kicajsky/zasilacz-warsztatowy-Altium/zasilacz zmontowany.jpg

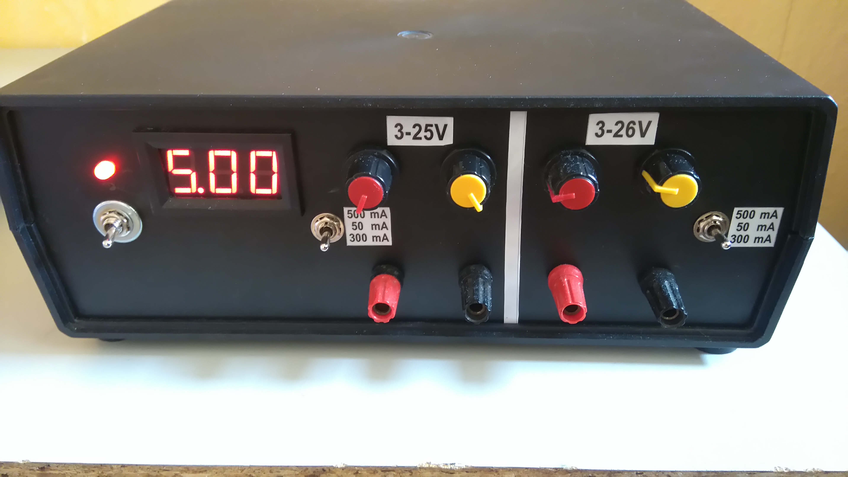
zasilacz zmontowany.jpg
