kicajsky/zasilacz-warsztatowy-Altium/Project Outputs for PCB_Project1/2017-02-09 11.30.52.jpg

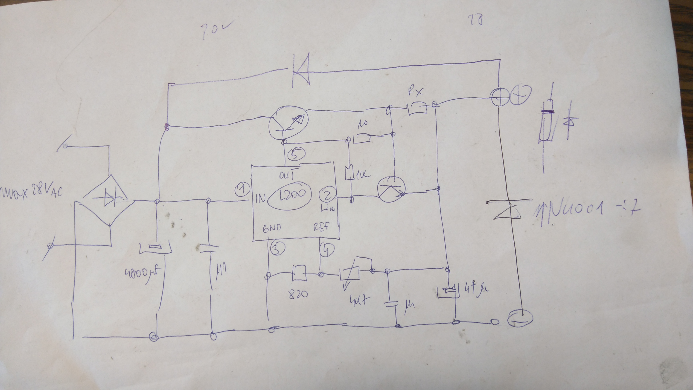
Project Outputs for PCB_Project1/2017-02-09 11.30.52.jpg
