kicajsky/zasilacz-warsztatowy-Altium/README.md

# zasilacz-warsztatowy-Altium
projekt zasilacza warsztatowego. 2x 3-25V 50-500mA do zasilania wzmacniaczy operacyjnych
