kicajsky/zasilacz-warsztatowy-Altium/Project Outputs for PCB_Project1/BOM.xls

Item # | Quantity | Designator | Description | Comment | LibRef
1 | 2 | C1, C2 | Capacitor (Semiconductor SIM Model) | Cap Semi | Cap Semi
2 | 1 | C3 | Polarized Capacitor (Radial) | Cap Pol1 | Cap Pol1
3 | 1 | C4 | Polarized Capacitor (Radial) | Cap Pol1 | Cap Pol1
4 | 1 | D1 | Typical INFRARED GaAs LED | LED0 | LED0
5 | 1 | D2 | Default Diode | Diode 159 | Diode
6 | 1 | D3 | 1 Amp General Purpose Rectifier | Diode 1N4001 | Diode 1N4001
7 | 1 | F1 | Fuse | Fuse 1 | Fuse 1
8 | 1 | J1 | IEC Mains Power Outlet, EN60 320-2-2 F Class I, PC Flange Rear Mount, Chassis Socket | Plug AC Female | Plug AC Female
9 | 1 | M1 | Full Wave Diode Bridge | Bridge1 | Bridge1
10 | 2 | OUT1, OUT2 | Wyjście zasilacza typu Banan | Banan | Banan
11 | 7 | R1, R2, R3, R4, R5, R6, R9 | Resistor | Res2 | Res2
12 | 2 | R7, R8 | Potentiometer | RPot | RPot
13 | 1 | S1 | Double-Pole, Single-Throw Switch | SW-DPST | SW-DPST
14 | 1 | SW1 | Single 3-stage toggle switch | toggle_switch_3_mono | toggle_switch_3_mono
15 | 1 | SW2 | Dual 3-stage toggle switch | toggle_switch_3 | toggle_switch_3
16 | 1 | T1 | Amplifier Transistor, NPN Silicon, 3-Pin TO-92, Bulk Box | BC547B | BC547B
17 | 1 | T2 | NPN Silicon Power Transistor, 3-Pin TO-220, Tube | BUV27 | BUV27
18 | 1 | Tr1 | Transformer (Coupled Inductor Model) | Trans Cupl | Trans Cupl
19 | 1 | US1 | Adjustable Voltage and Current Regulator, 5-Pin Pentawatt, Tube | L200C | L200CV
20 | 1 | V1 | Woltomierz DC 1-30V | Woltomierz | woltomierz
21 | 2 | Z1, Z2 | Połączenie z płytką pcb. Przewodem z uzwojenia wtórnego do mostka Gretza | Connect | NET
