kicajsky/zasilacz-warsztatowy-Altium/Project Outputs for PCB_Project1/pcb1.pdf

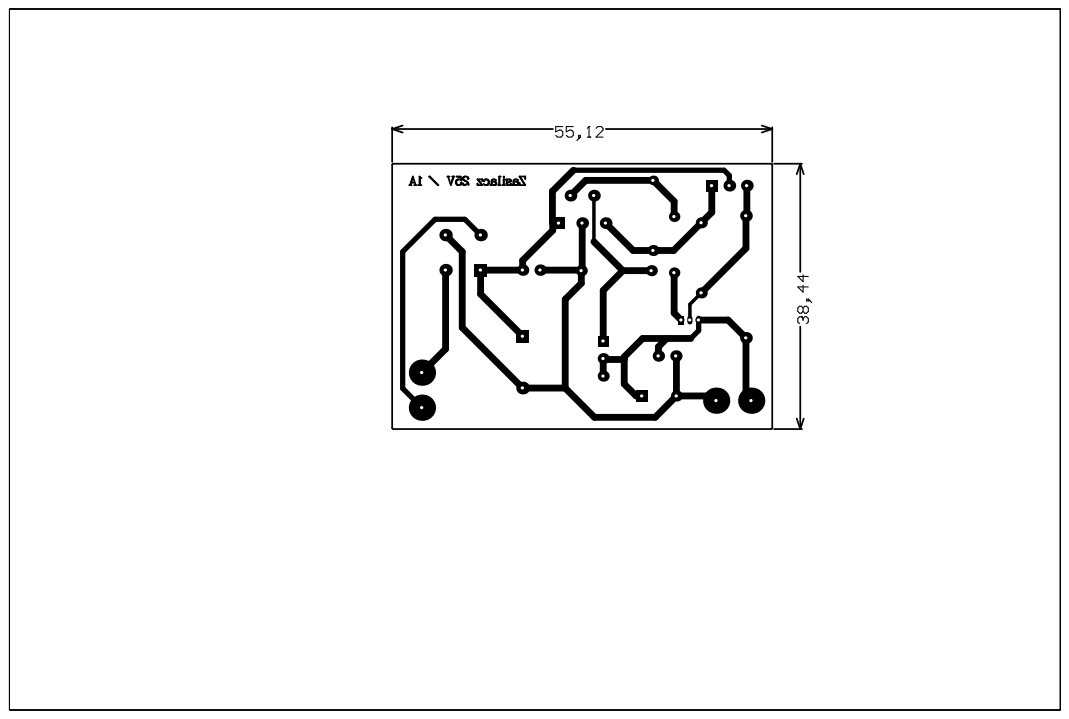
[picture p5: page 1]

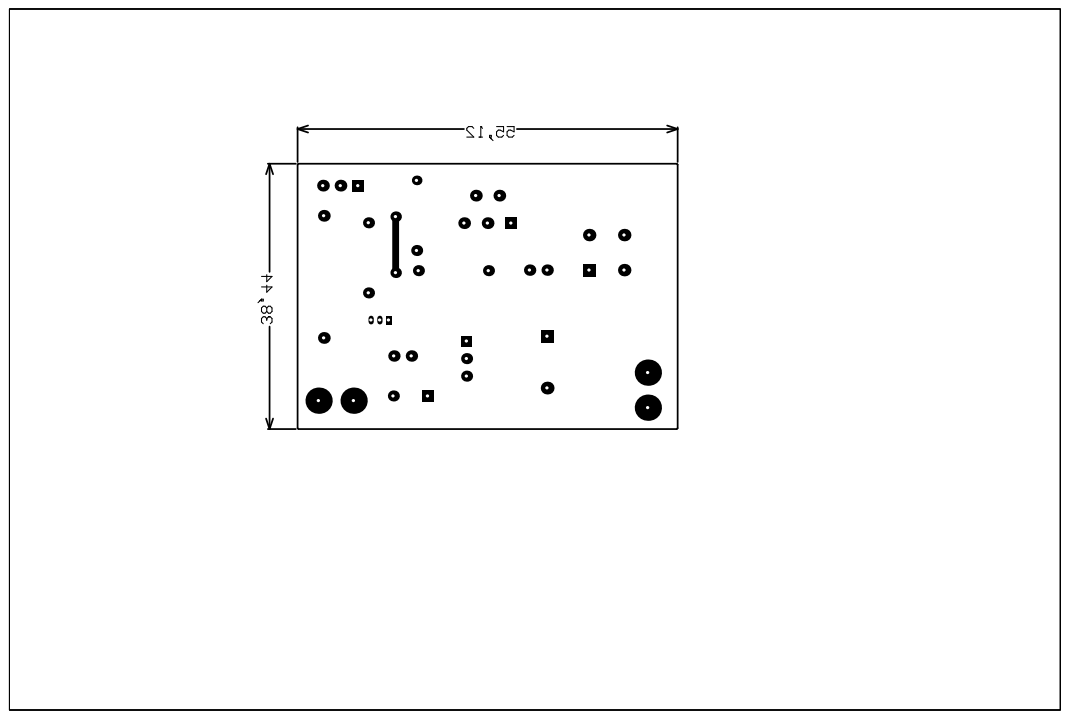
[picture p6: page 2]

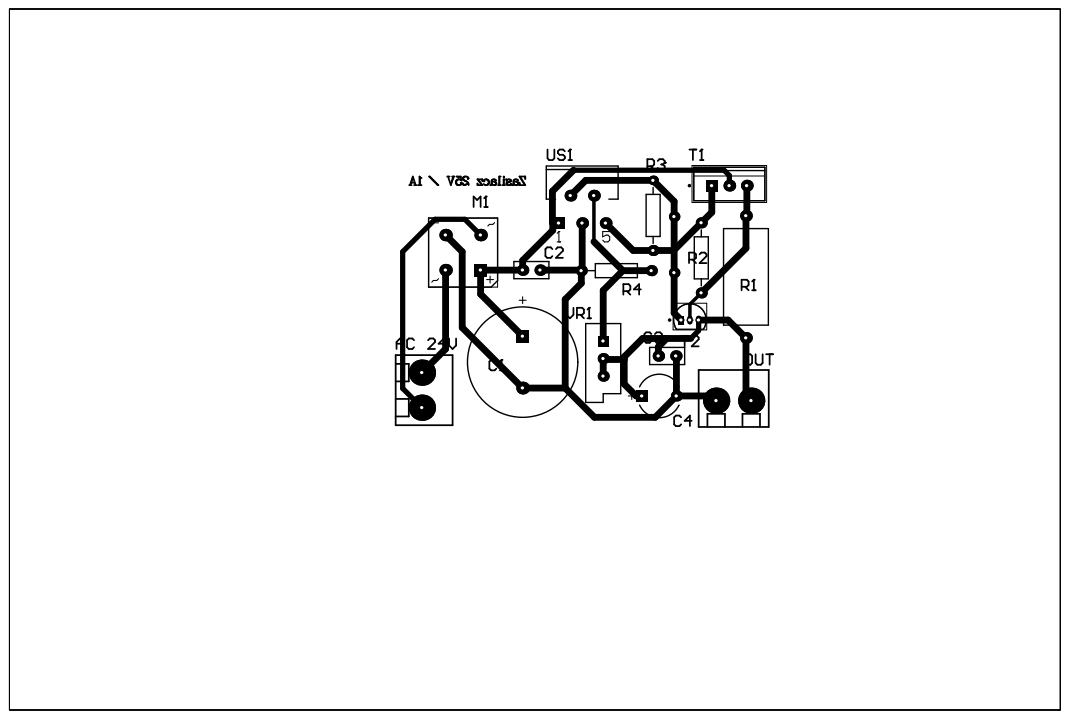
[picture p7: page 3]
