kicajsky/zasilacz-warsztatowy-Altium/Project Outputs for PCB_Project1/Schemat.PDF

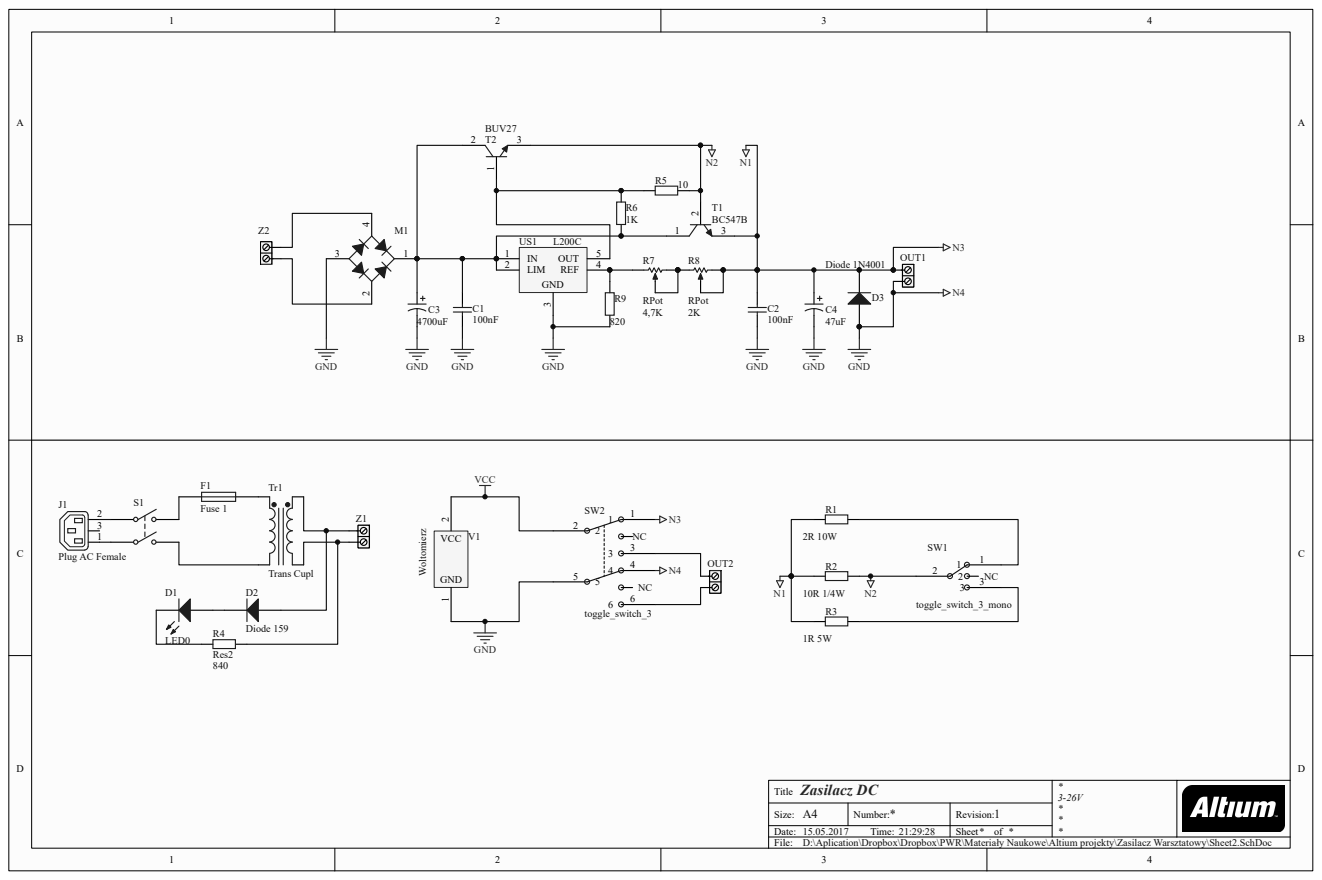
[picture p8: page 1]

Zasilacz DC
Title
D:\Aplication\Dropbox\Dropbox\PWR\Materiały Naukowe\Altium projekty\Zasilacz Warsztatowy\Sheet2.SchDoc
