kicajsky/zasilacz-warsztatowy-Altium/(list of files, drawings)

Other design files:
Copy of MainBoardPcb.PcbDoc
PCB1.PcbDoc
PCB_Project1.PrjPCB
Sheet1.SchDoc
Sheet2.SchDoc
zasilacz lib/PcbLib1.PcbLib
zasilacz lib/switche.SchLib
zasilacz lib/voltomierz1.SchLib
zasilacz lib/voltomierz.SchLib
zasilacz lib/zasilacz_lib.SchLib
